Aynril/NEW_SAM/BetterBase/Base/src/sensors/AirPressureSensor.h

#pragma once

#include "../inc/BaseConfig.h"
#include <Adafruit_BMP280.h>

class AirPressureSensor
{
private:
    Adafruit_BMP280 bmp;
public:
    AirPressureSensor() { };

    void init();
    float getTemperature();
    float getPressure();
    float getAltitute();
};
