Aynril/NEW_SAM/(commit log)

2020-06-28 Fixed the fucking error
    [lcd.h, main.cpp]
2020-07-16 Such beauty
    [Configuration.h]
2020-07-17 Added a lot of stuff
    [Configuration.h]
2020-07-18 Fuck i think i finish
    [Configuration.h]
2020-07-21 Should work, mostly
    [Configuration.h]
2020-08-02 Wind Sensor shit
    [Configuration.h]
2020-08-03 Works Kinda
    [Configuration.h]
2020-10-09 Fuck I hate it. Chekc wires
    [Configuration.h]
2020-10-11 Lol that's a lot
    [Configuration.h]
2020-10-13 Fuck you plz send
    [Configuration.h]
2020-10-22 Hopefully removed a bug for scrolling
    [lcd.h, main.cpp]
2020-10-22 Better change and later timer
